MaheshKarnani/Switch_maze/Modules_SM/SingleEntryModule/parts_3d_print/nest_ladder.stl

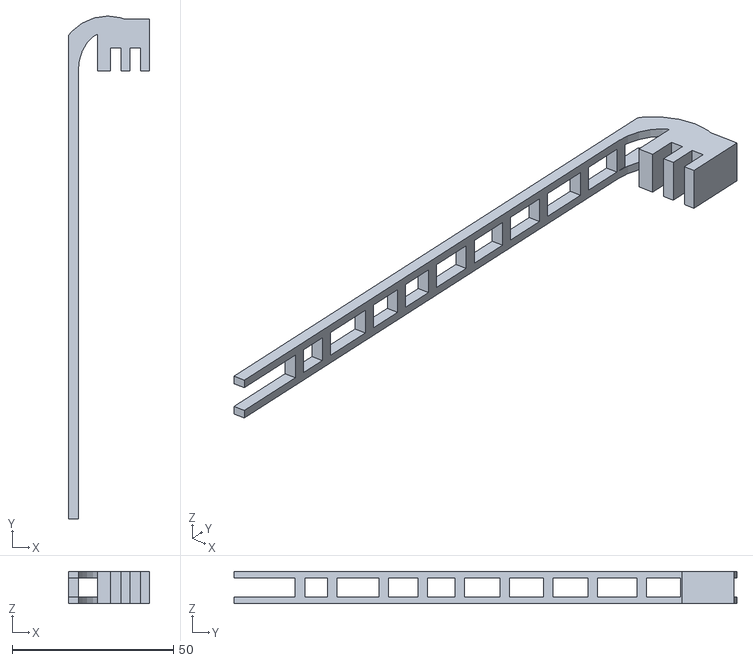
[picture p13: CAD file, 2023-04-16]
Modules_SM/SingleEntryModule/parts_3d_print/nest_ladder.stl
25.0 x 156.0 x 10.0
