MaheshKarnani/Switch_maze/Modules_SM/SwitchMaze/parts_3d_print/HSD_door_stopper.stl

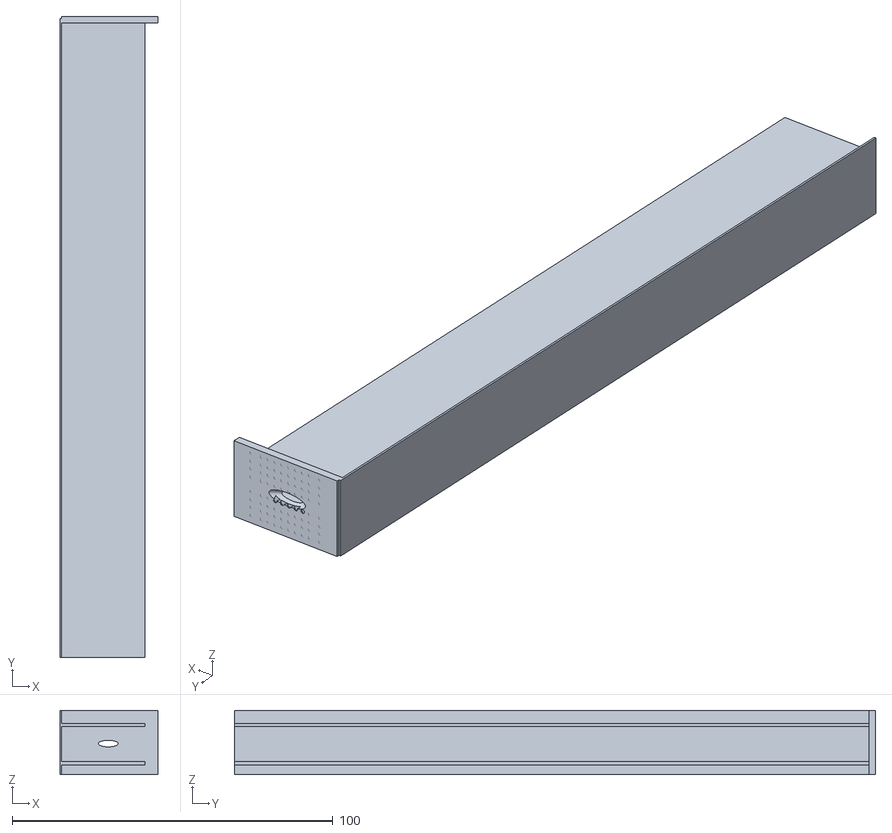
[picture p14: CAD file, 2023-05-19]
Modules_SM/SwitchMaze/parts_3d_print/HSD_door_stopper.stl
30.5 x 200.0 x 20.0
