MaheshKarnani/Switch_maze/Modules_SM/TimedRunningWheel/parts_3d_print/rw_base.stl

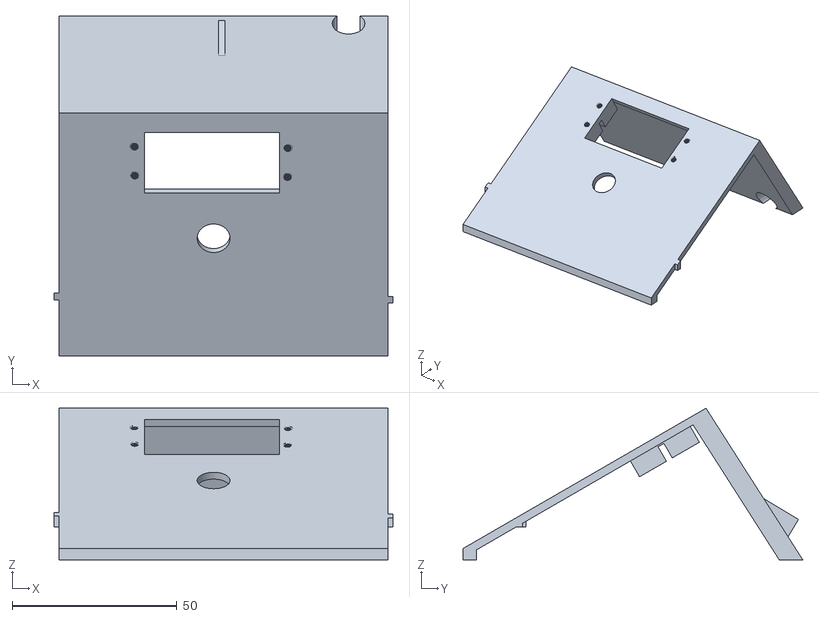
[picture p15: CAD file, 2023-02-13]
Modules_SM/TimedRunningWheel/parts_3d_print/rw_base.stl
103.0 x 103.2 x 46.0
