MaheshKarnani/Switch_maze/Modules_SM/SingleEntryModule/parts_3d_print/rfid_base.stl

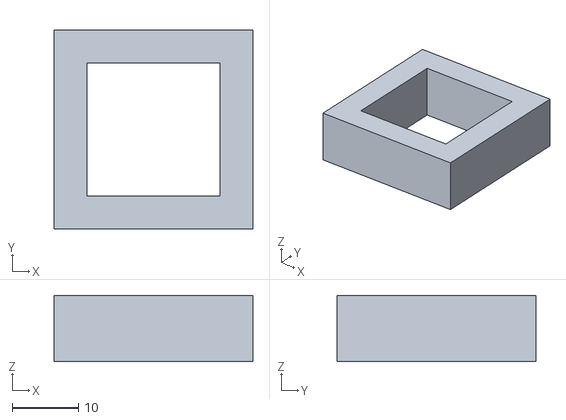
[picture p16: CAD file, 2023-02-14]
Modules_SM/SingleEntryModule/parts_3d_print/rfid_base.stl
30.0 x 30.0 x 10.0
