MaheshKarnani/Switch_maze/Modules_SM/TimedRunningWheel/parts_3d_print/rw_cover.stl

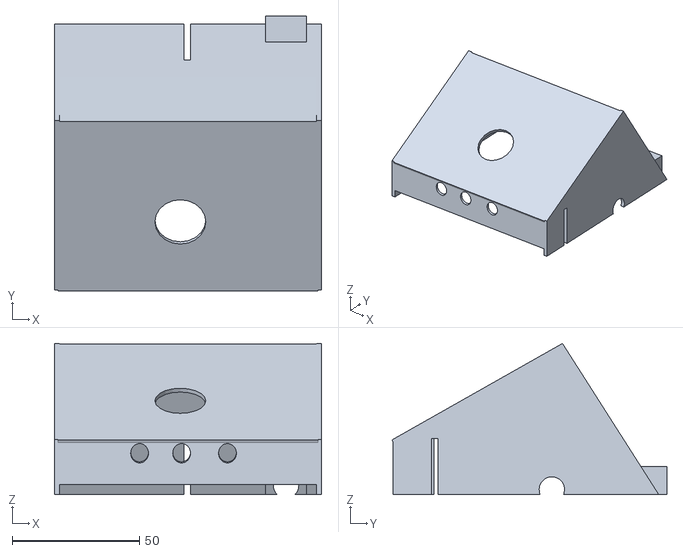
[picture p18: CAD file, 2023-02-13]
Modules_SM/TimedRunningWheel/parts_3d_print/rw_cover.stl
105.0 x 108.0 x 59.3
