MaheshKarnani/Switch_maze/Modules_SM/SwitchMaze/parts_3d_print/bb345_send.stl

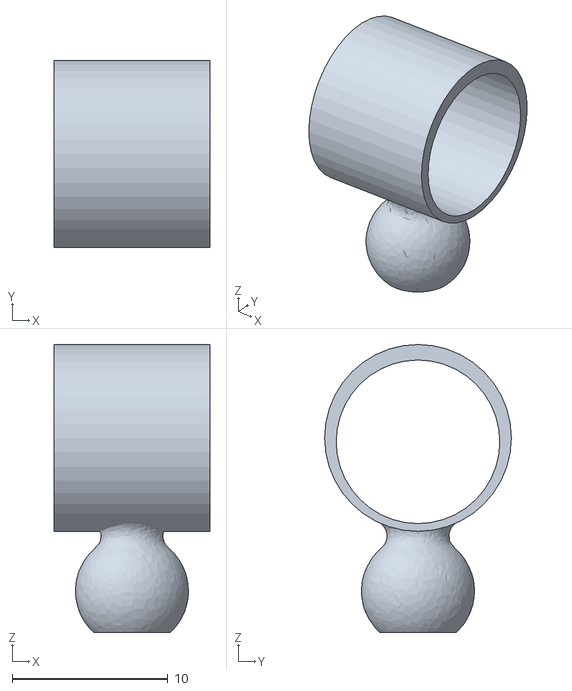
[picture p19: CAD file, 2023-02-28]
Modules_SM/SwitchMaze/parts_3d_print/bb345_send.stl
10.0 x 12.0 x 18.5
