MaheshKarnani/Switch_maze/Modules_SM/SingleEntryModule/parts_3d_print/bb1_send.stl

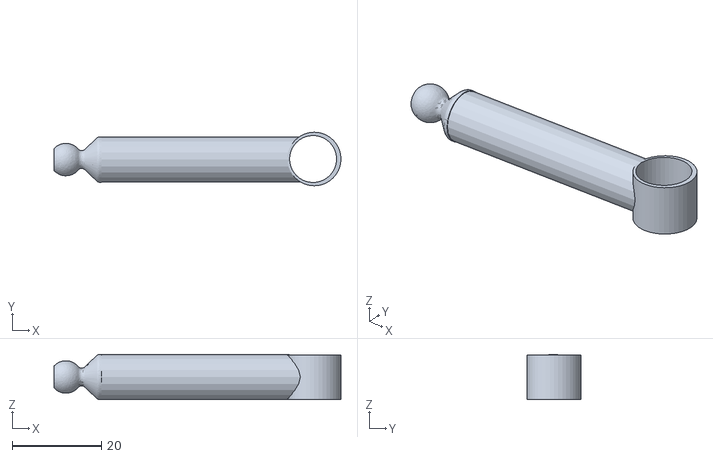
[picture p20: CAD file, 2023-02-13]
Modules_SM/SingleEntryModule/parts_3d_print/bb1_send.stl
64.2 x 12.0 x 10.2
