MaheshKarnani/Switch_maze/Modules_SM/SwitchMaze/parts_3d_print/HSD_door_guide_bottomR.stl

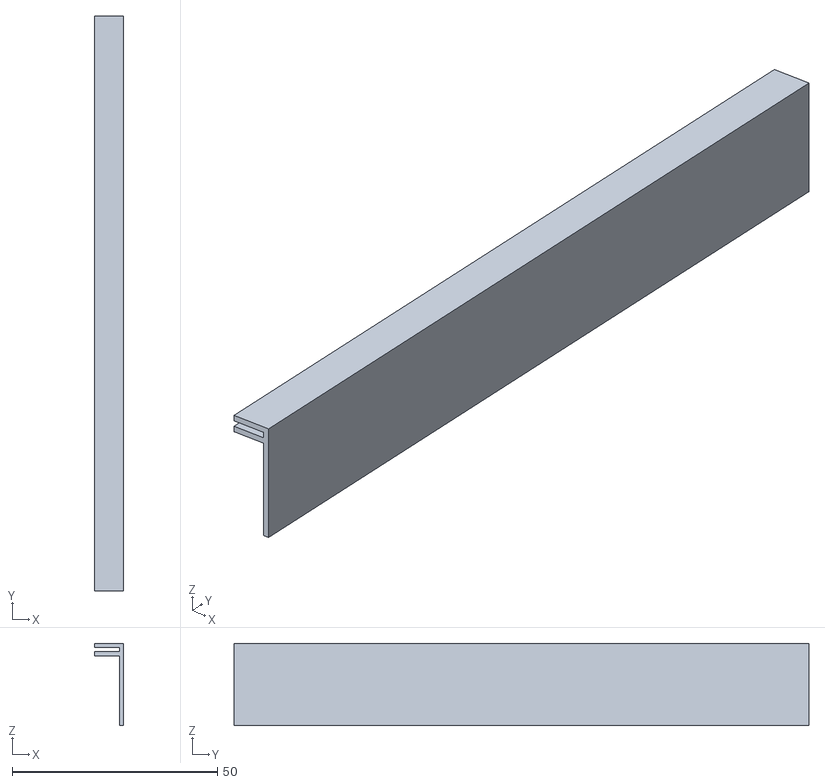
[picture p21: CAD file, 2023-02-28]
Modules_SM/SwitchMaze/parts_3d_print/HSD_door_guide_bottomR.stl
7.00 x 140.0 x 20.0
