MaheshKarnani/Switch_maze/Modules_SM/SingleEntryModule/parts_3d_print/scale1.stl

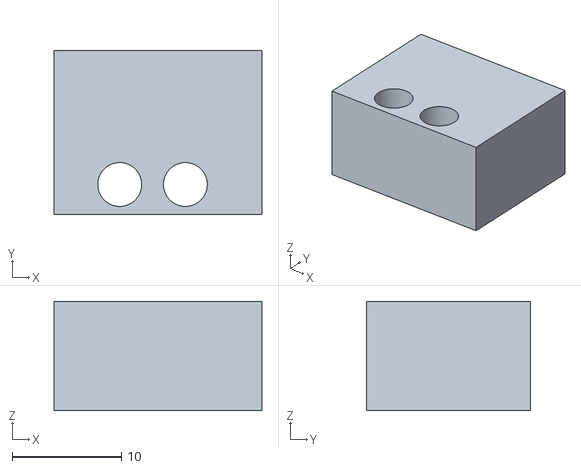
[picture p22: CAD file, 2023-02-13]
Modules_SM/SingleEntryModule/parts_3d_print/scale1.stl
19.0 x 15.0 x 10.0
