MaheshKarnani/Switch_maze/Modules_SM/SwitchMaze/parts_3d_print/HSD_door_guide_top.stl

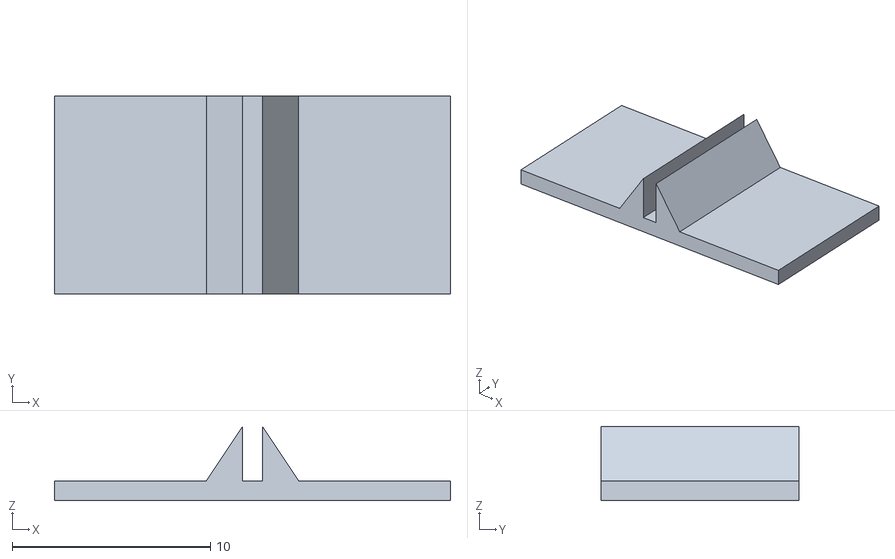
[picture p23: CAD file, 2023-02-28]
Modules_SM/SwitchMaze/parts_3d_print/HSD_door_guide_top.stl
20.0 x 10.0 x 3.75
