MaheshKarnani/Switch_maze/Modules_SM/SingleEntryModule/parts_3d_print/bb2_receive.stl

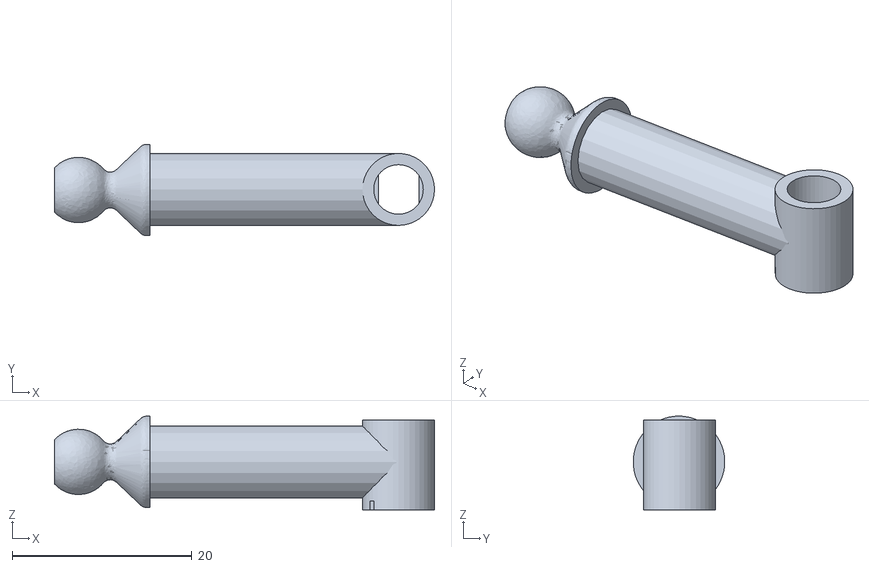
[picture p24: CAD file, 2023-02-13]
Modules_SM/SingleEntryModule/parts_3d_print/bb2_receive.stl
42.2 x 10.2 x 10.4
