MaheshKarnani/Switch_maze/Modules_SM/SwitchMaze/parts_3d_print/bb345_receive.stl

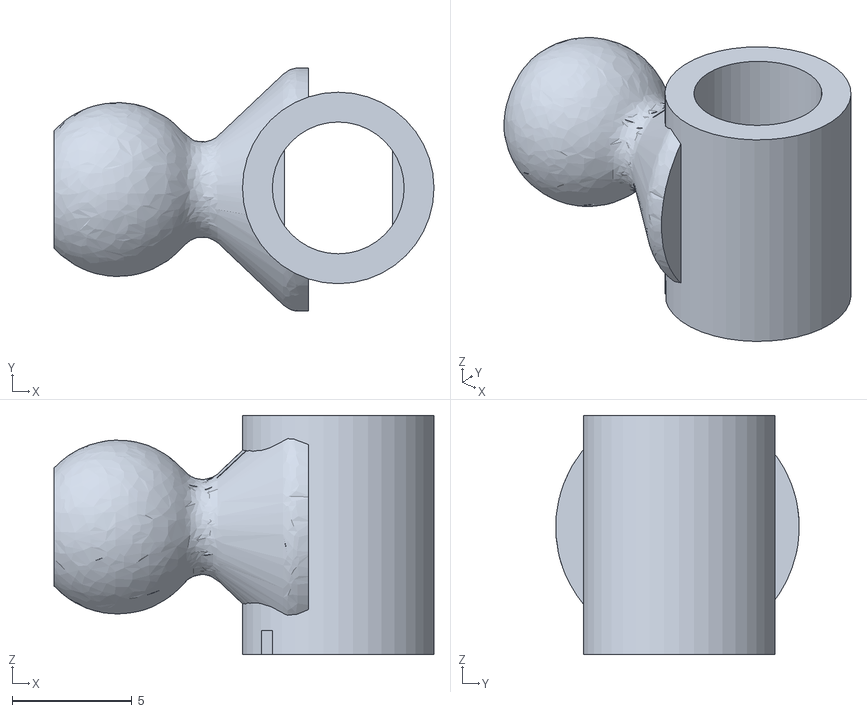
[picture p25: CAD file, 2023-02-28]
Modules_SM/SwitchMaze/parts_3d_print/bb345_receive.stl
15.9 x 10.2 x 10.0
