MaheshKarnani/Switch_maze/Modules_SM/SingleEntryModule/parts_3d_print/door_base.stl

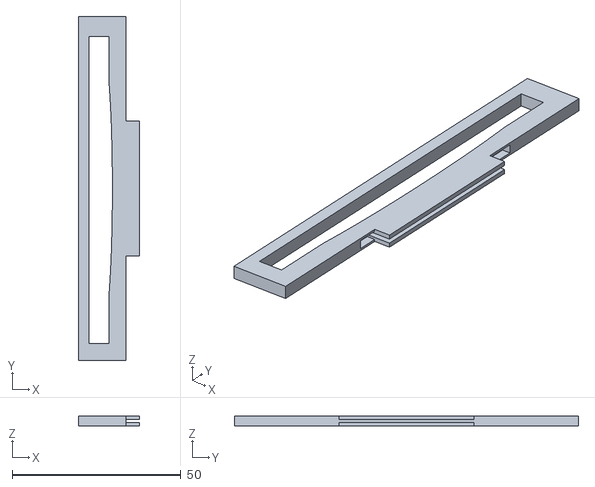
[picture p26: CAD file, 2023-02-13]
Modules_SM/SingleEntryModule/parts_3d_print/door_base.stl
18.0 x 102.0 x 3.00
