MaheshKarnani/Switch_maze/Modules_SM/SwitchMaze/parts_3d_print/bb_base.stl

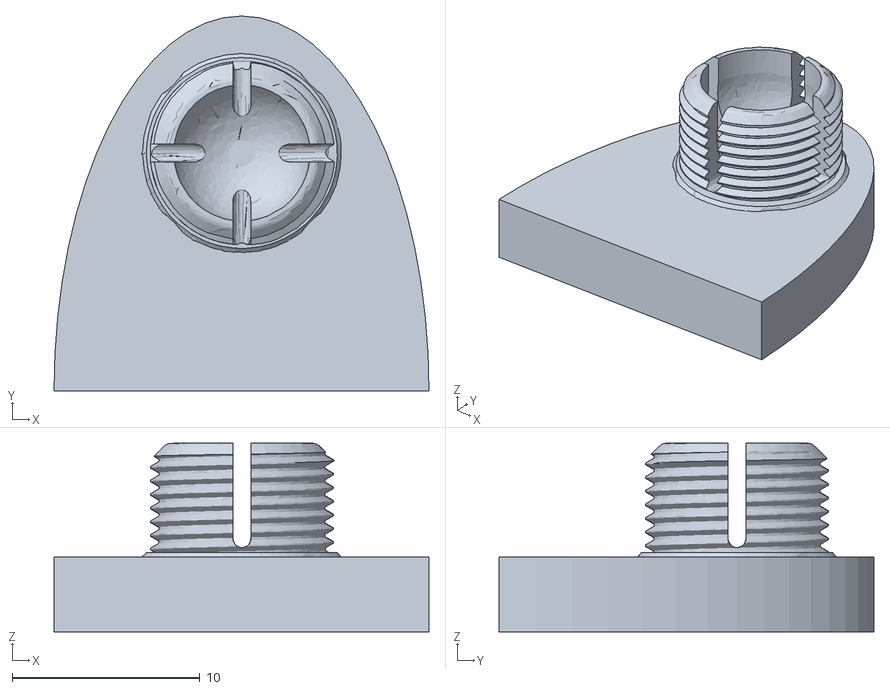
[picture p28: CAD file, 2023-02-13]
Modules_SM/SwitchMaze/parts_3d_print/bb_base.stl
20.0 x 20.0 x 10.1
