MaheshKarnani/Switch_maze/Modules_SM/SingleEntryModule/parts_3d_print/scale3.stl

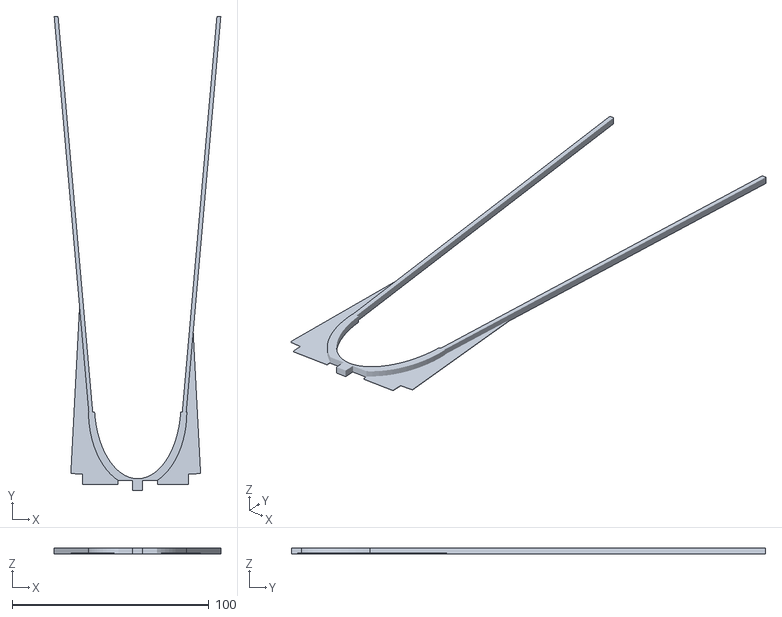
[picture p29: CAD file, 2023-02-13]
Modules_SM/SingleEntryModule/parts_3d_print/scale3.stl
84.7 x 241.0 x 3.00
