MaheshKarnani/Switch_maze/Modules_SM/SwitchMaze/parts_3d_print/servo_clamp.stl

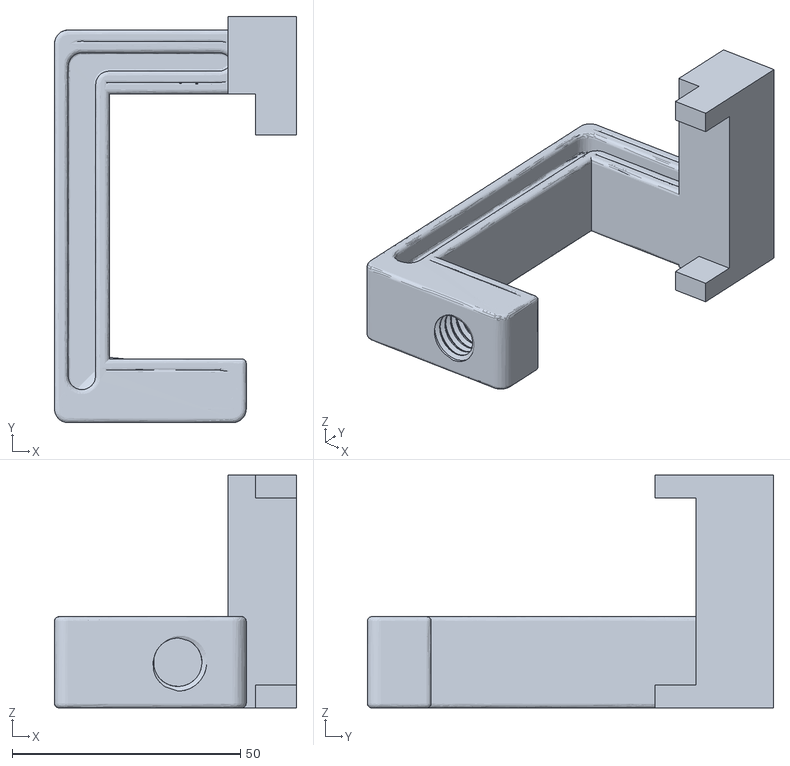
[picture p30: CAD file, 2023-02-13]
Modules_SM/SwitchMaze/parts_3d_print/servo_clamp.stl
53.0 x 89.0 x 51.0
