MaheshKarnani/Switch_maze/Modules_SM/SingleEntryModule/parts_3d_print/scale4.stl

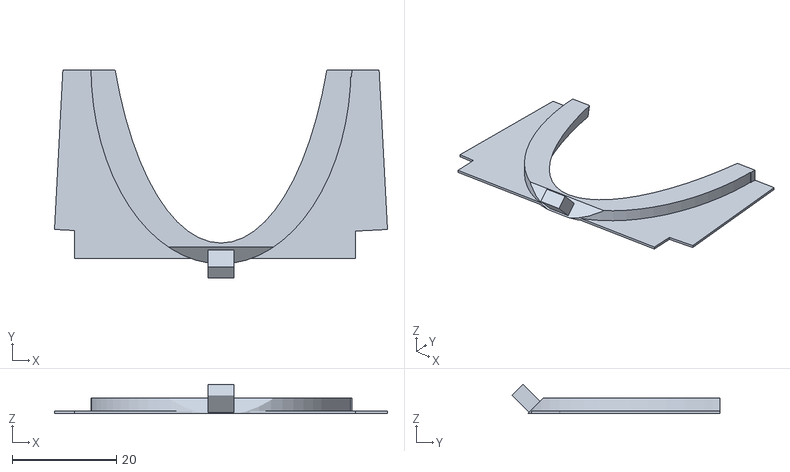
[picture p31: CAD file, 2023-02-13]
Modules_SM/SingleEntryModule/parts_3d_print/scale4.stl
64.0 x 40.0 x 5.66
