MaheshKarnani/Switch_maze/Modules_SM/SingleEntryModule/parts_3d_print/scale2.stl

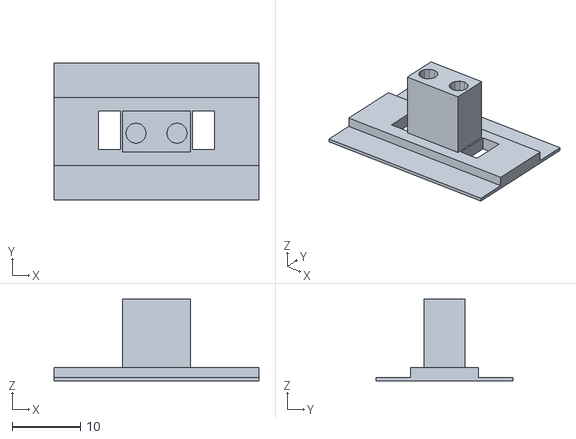
[picture p32: CAD file, 2023-02-13]
Modules_SM/SingleEntryModule/parts_3d_print/scale2.stl
30.0 x 20.0 x 12.0
