MaheshKarnani/Switch_maze/(list of files, cad)

Other CAD files:
Modules_SM/SingleEntryModule/parts_3d_print/bb1_receive.stl
Modules_SM/SingleEntryModule/parts_3d_print/door_base_nut.stl
Modules_SM/SwitchMaze/parts_3d_print/bb_base_nut.stl
Modules_SM/SwitchMaze/parts_3d_print/servo_bolt.stl
Modules_SM/SwitchMaze/parts_3d_print/servo_bolt_cap.stl
