MaheshKarnani/Switch_maze/(commit log)

2022-08-11 python commit
    [34443624728_weight.csv, 34443624890_weight.csv]
2022-08-11 weights from 5s automatic measurement during entry
    [adf_weight.csv, asd_weight.csv]
2022-12-08 Create requirements.txt
    pip freeze from raspberry pi 4 that ran the first switch maze
2024-04-01 Add files via upload
    may be unstable
    [Switch_maze_functions_email.py, Switch_maze_main_email.py]
2024-04-01 Add files via upload
    fixed
    [Switch_maze_functions_email.py]
